Alejandro-KO/Mini-sumo-REM/IMG_20210524_221510.jpg

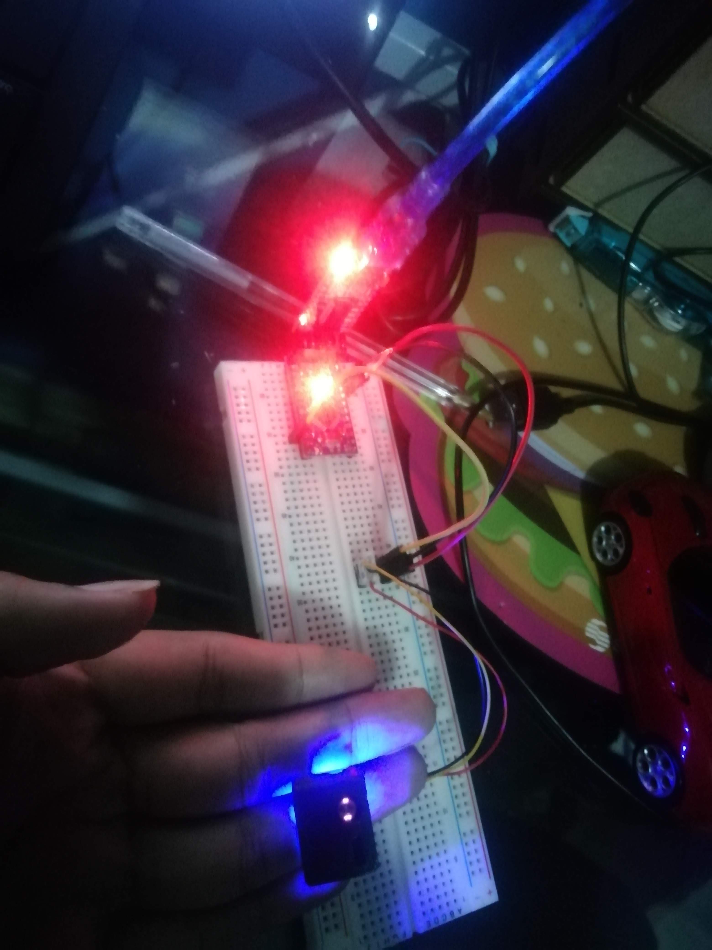
IMG_20210524_221510.jpg
