Alejandro-KO/Mini-sumo-REM/IMG_20210608_114437.jpg

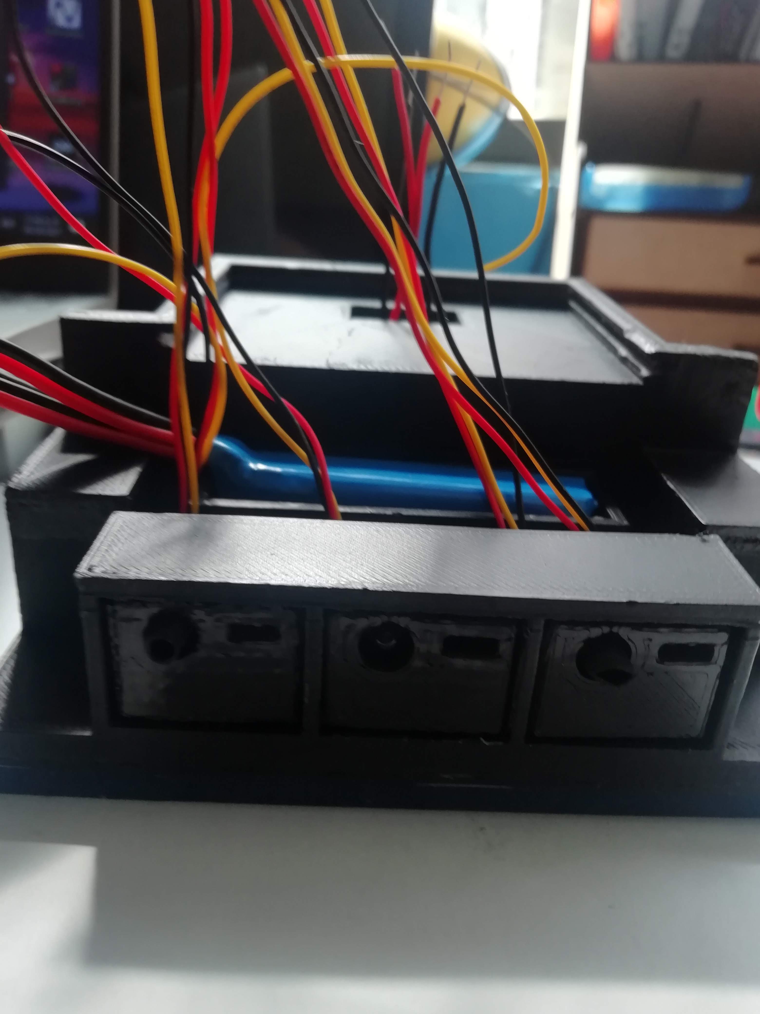
IMG_20210608_114437.jpg
