Alejandro-KO/Mini-sumo-REM/DOCUMENTACION/4to Avance de Proyecto.pdf

## “Avances de Proyecto”

## Titulo del proyecto: R.E.M Integrante(es): Israel Alejandro Murillo García Asesor(es): David de Jesús Ulises Hernández González

## Fecha de entrega

## Jun 2021

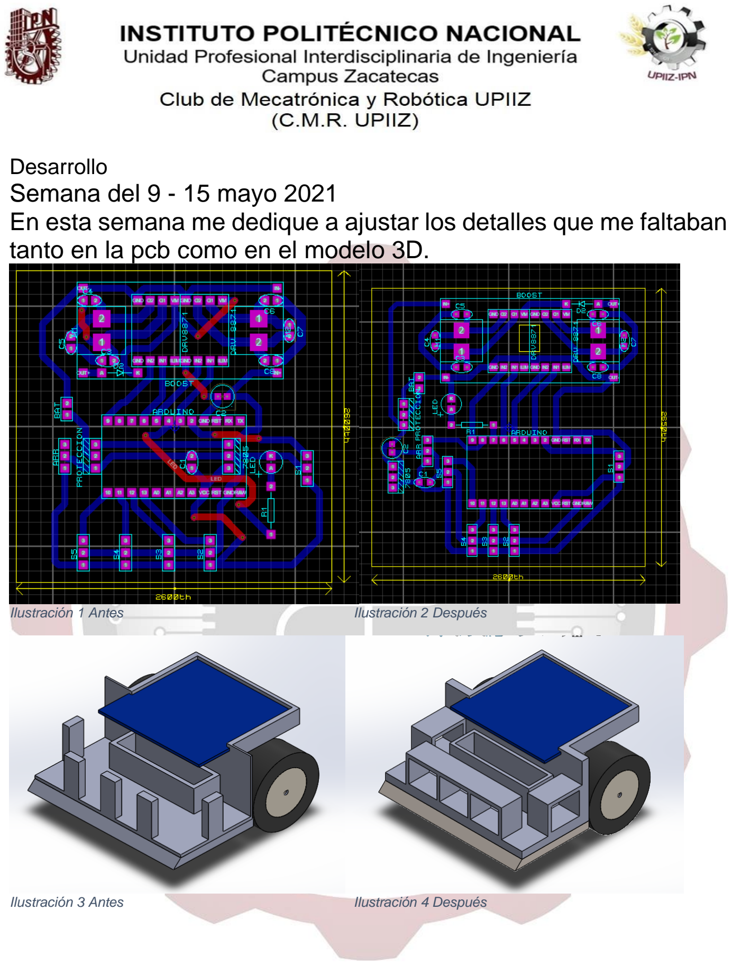
[picture p25: page 2]

Desarrollo
Semana del 9 - 15 mayo 2021
En esta semana me dedique a ajustar los detalles que me faltaban tanto en la pcb como en el modelo 3D.
Ilustración 1 Antes | Ilustración 2 Después
Ilustración 3 Antes | Ilustración 4 Después

Semana del 16 – 22 de mayo de 2021 Realice pruebas con los sensores.

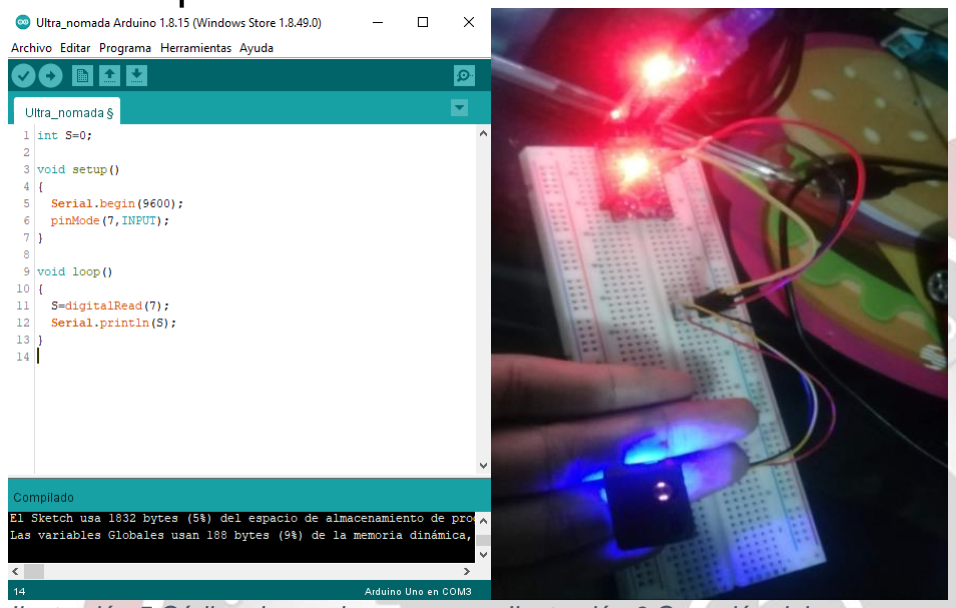
[picture p26: figure]

Ilustración 5 Código de pruebas | Ilustración 6 Conexión del sensor
No jalaron 2 de los sensores.

En estos días me eh atrasado un poco con el proyecto pero es debido a que últimamente eh tenido muchos trabajos de clase y no me dejan mucho tiempo para poder avanzar de mejor manera
