Alejandro-KO/Mini-sumo-REM/DOCUMENTACION/Avance de proyecto.pdf

# “Avances de Proyecto”

# Titulo del proyecto: R.E.M Integrante(es): Israel Alejandro Murillo García Asesor(es): David Hernández

# Fecha de entrega (ejem: marzo 2021):

Descripción de actividades realizadas en las 2 semanas de trabajo previas a la reunión de avances, asiendo énfasis en:

- Que días se realizaron.
- Quienes participaron.
- Que se realizo.
- Que falto (material, herramienta, diseño, cálculos, etc.).
- Que tipo de pruebas de realizaron (en caso de haber hecho).

El desarrollo de este formato es bastante libre, con la intención de que sea rápido de crear, deben ser al menos 2 cuartillas de información.
Nota: Agregar toda la evidencia posible (fotos, diagramas, simulaciones, diseños, etc.)
Nota 2: El listado anterior NO esta en orden, puede ser reorganizado cómo se crea conveniente.

Desarrollo
En estas semanas de trabajo el avance fue muy reducido, esto debido a la semana de exámenes.
Se realizo la investigación de los componentes que usare para la realización de mi robot mini sumo, así como el funcionamiento de algunos de ellos:
Sensores ultrasónicos

Estos sensores funcionan a base de emisión de ondas de sonido mandando y recibiendo ondas para así poder medir una distancia.


Puente h drv8871
Con estos circuitos integrados se va a controlar la velocidad de los motores


Tarjeta Arduino pro mini


En esta tarjeta se realizará todo el código del mini sumó

Elevador de voltaje Boost Xl6009 con este dispositivo se puede dar mayor potencia a los
moteres


Bateria de li-po de 350mAh

Esta es la batería que dará poder al mini sumo entre mas amperaje tenga mayor duración tendrá

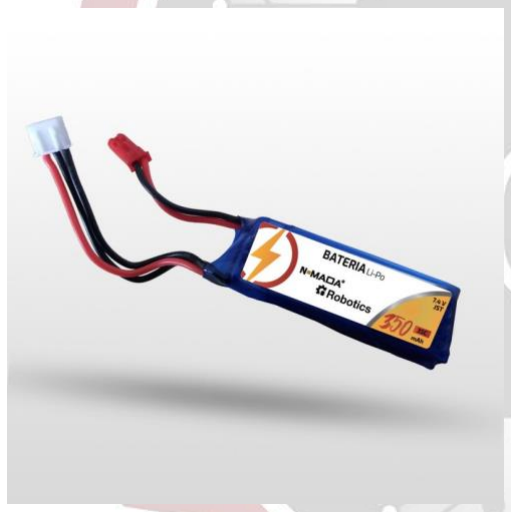
[picture p27: figure]
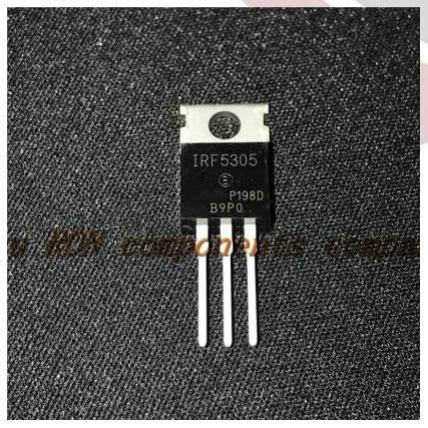
[picture p28: figure]

Mosfet irf5305
Este componente me ayudara a que no ocurra un corto al conectar de manera correcta la bateria
