Alejandro-KO/Mini-sumo-REM/DOCUMENTACION/Avances de Proyecto.docx

“Avances de Proyecto”

Titulo del proyecto:

R.E.M

Integrante(es):

Israel Alejandro Murillo García

Asesor(es):

David de Jesús Ulises Hernández González

Fecha de entrega

Jun 2021

Desarrollo

En estas dos semanas estuve trabajando en la etapa final de mi proyecto, teniendo así ya la placa, el modelo 3D impreso y la base donde van los motores

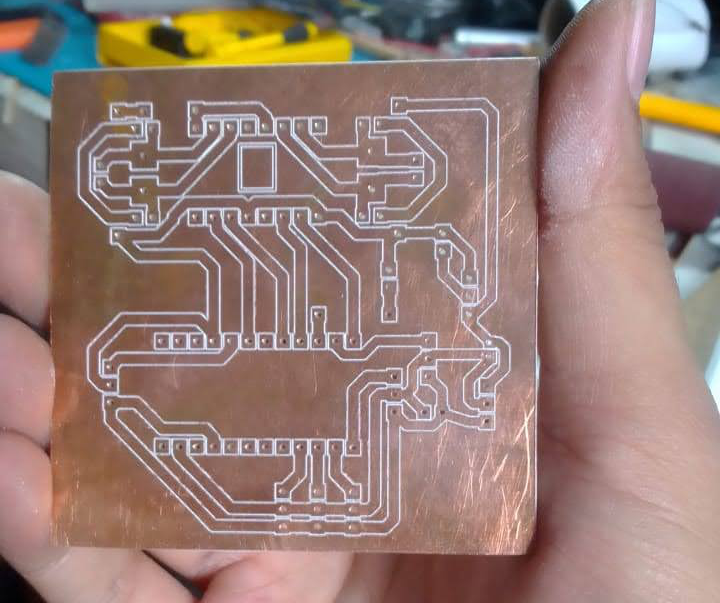
[picture p29: figure]
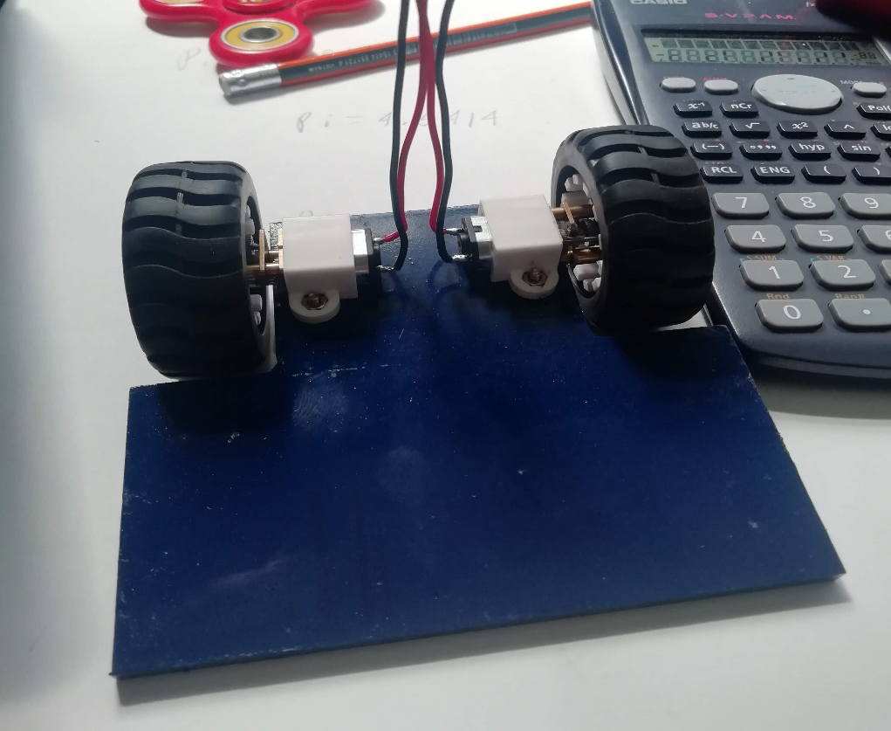
[picture p30: figure]
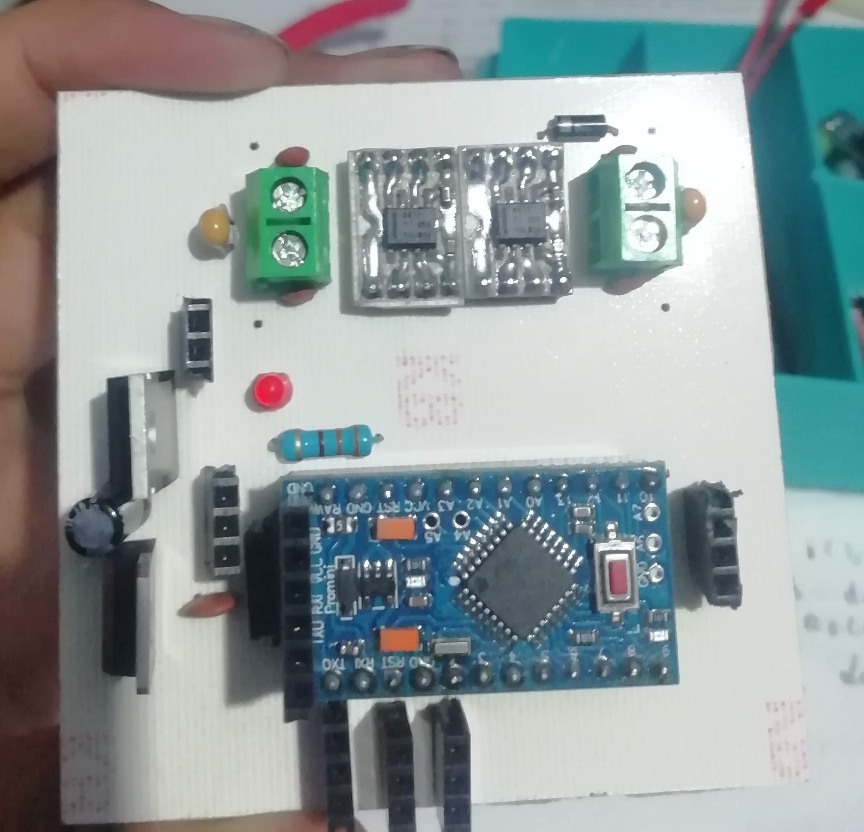
[picture p31: figure]
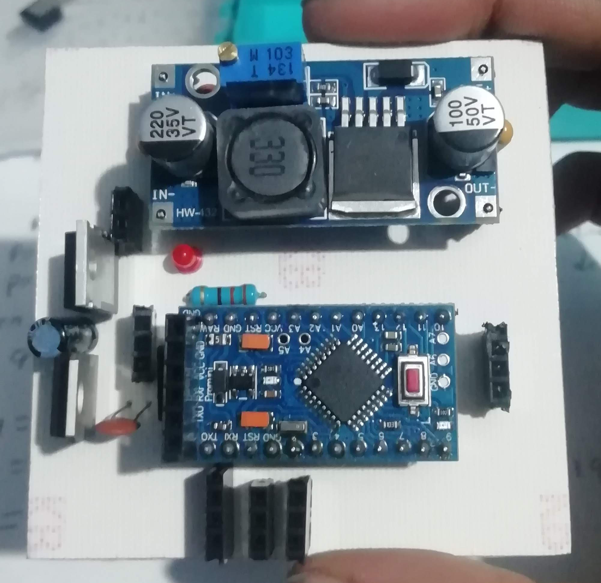
[picture p32: figure]
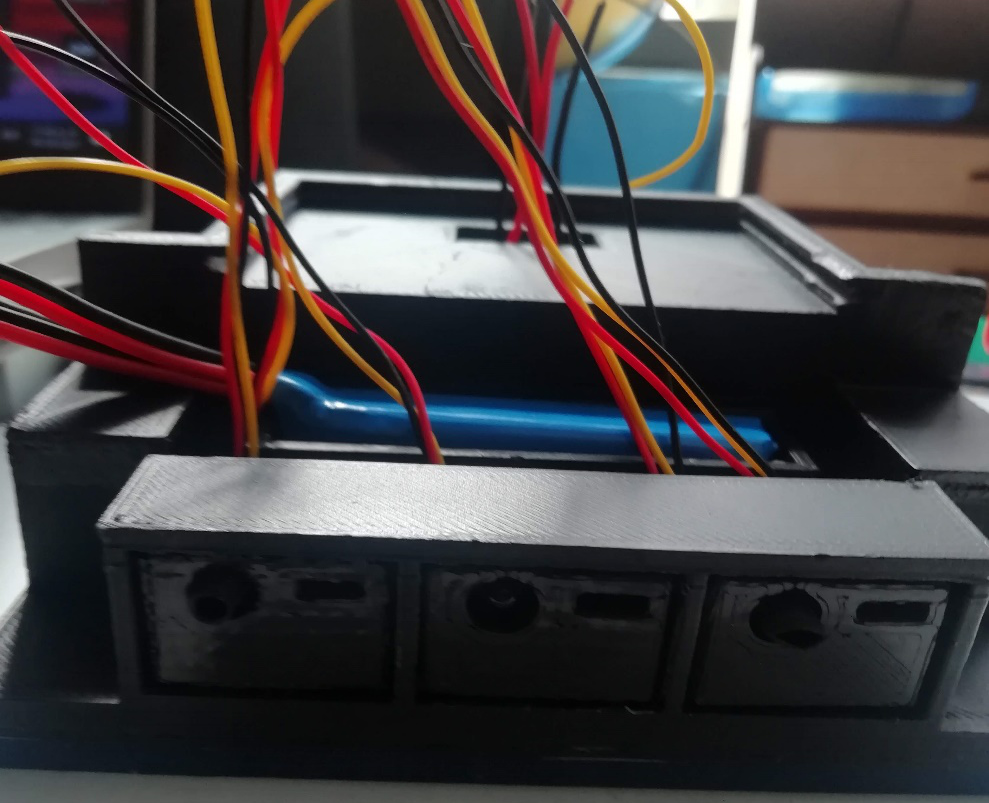
[picture p33: figure]
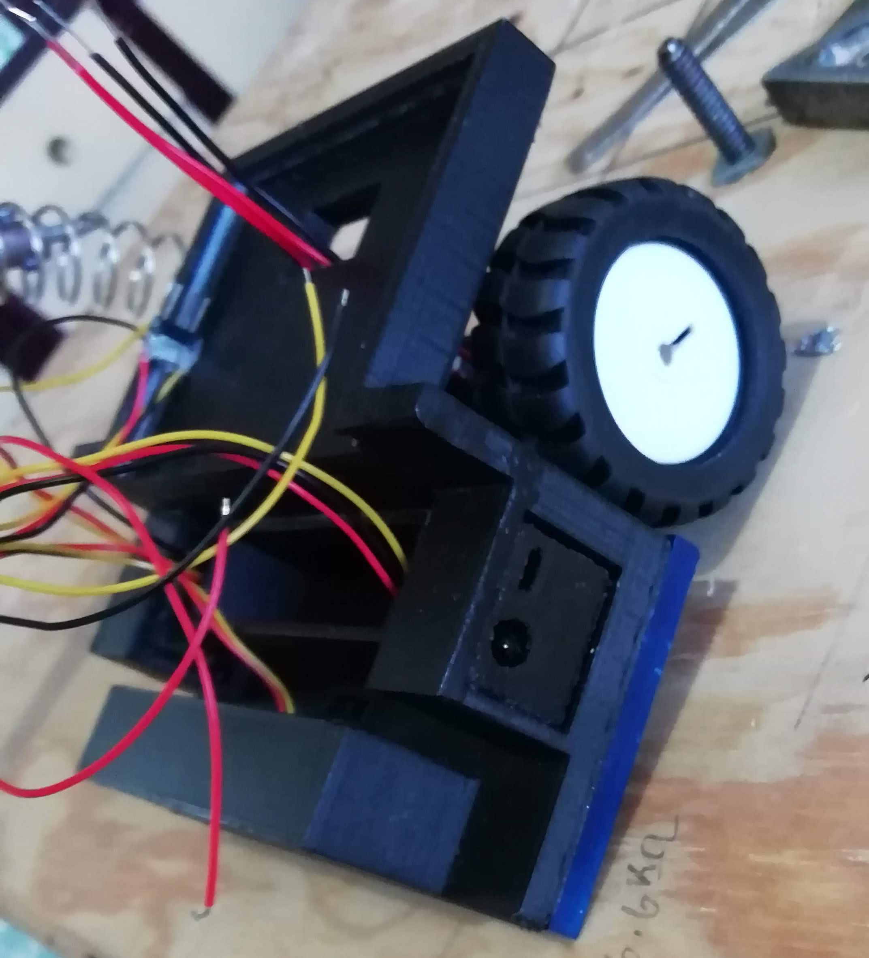
[picture p34: figure]
