Alejandro-KO/Mini-sumo-REM/DOCUMENTACION/5to Avance de Proyecto.pdf

# “Avances de Proyecto”

# Titulo del proyecto: R.E.M Integrante(es): Israel Alejandro Murillo García Asesor(es): David de Jesús Ulises Hernández González

# Fecha de entrega

# Jun 2021

Desarrollo
En estas dos semanas estuve trabajando en la etapa final de mi proyecto, teniendo así ya la placa, el modelo 3D impreso y la base donde van los motores

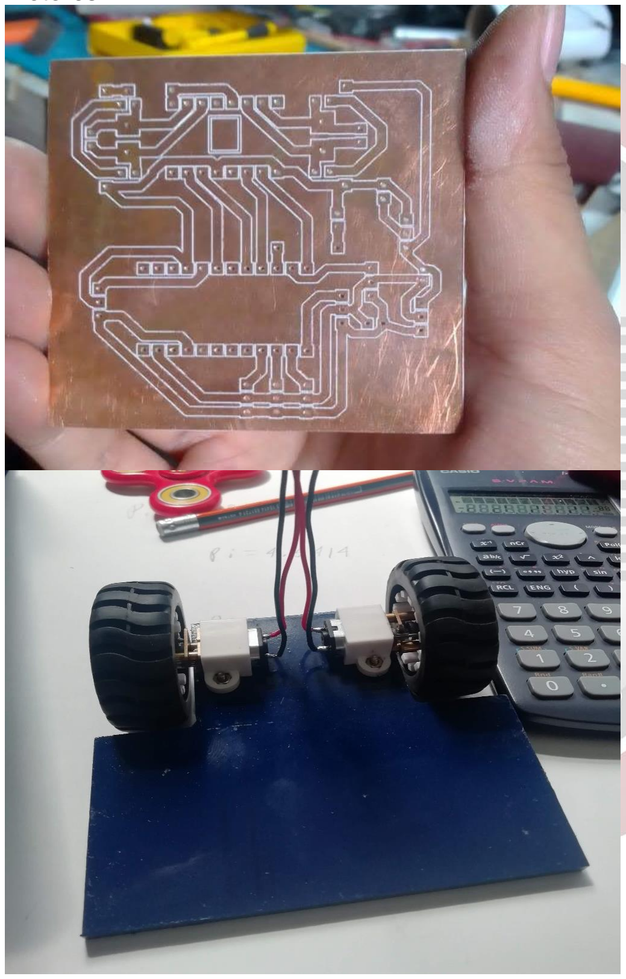
[picture p35: figure]

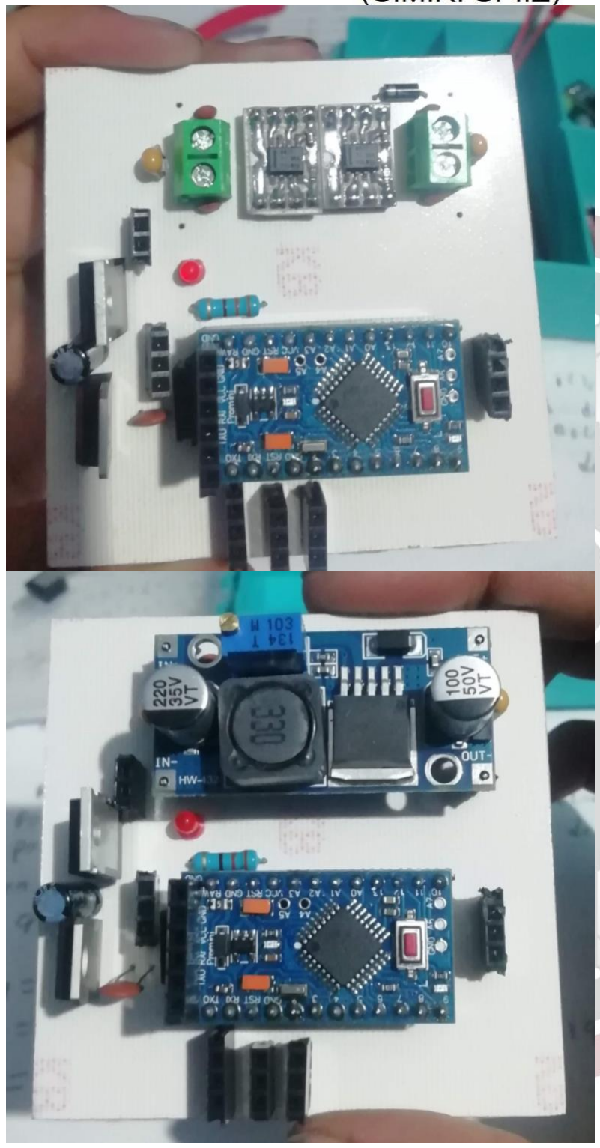
[picture p36: figure]

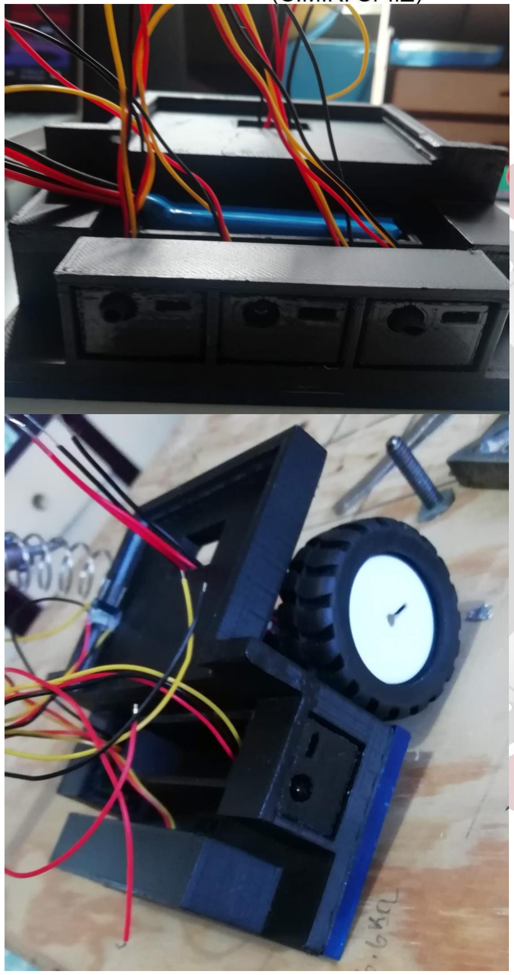
[picture p37: figure]
