Alejandro-KO/Mini-sumo-REM/IMG-20210607-WA0034.jpg

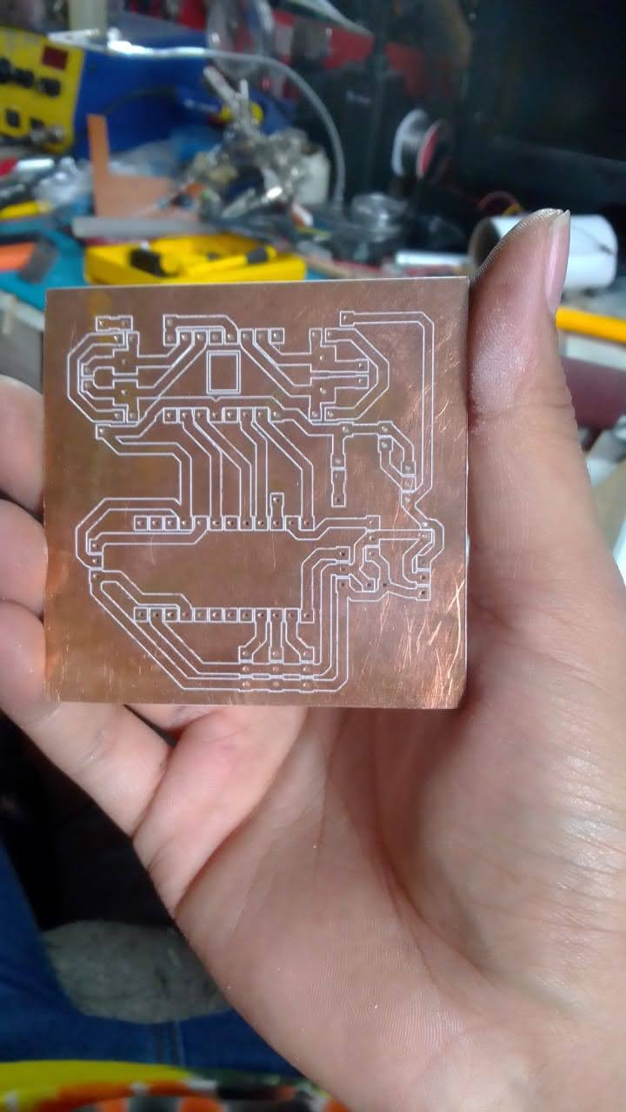
IMG-20210607-WA0034.jpg
