Alejandro-KO/Mini-sumo-REM/IMG_20210404_165855.jpg

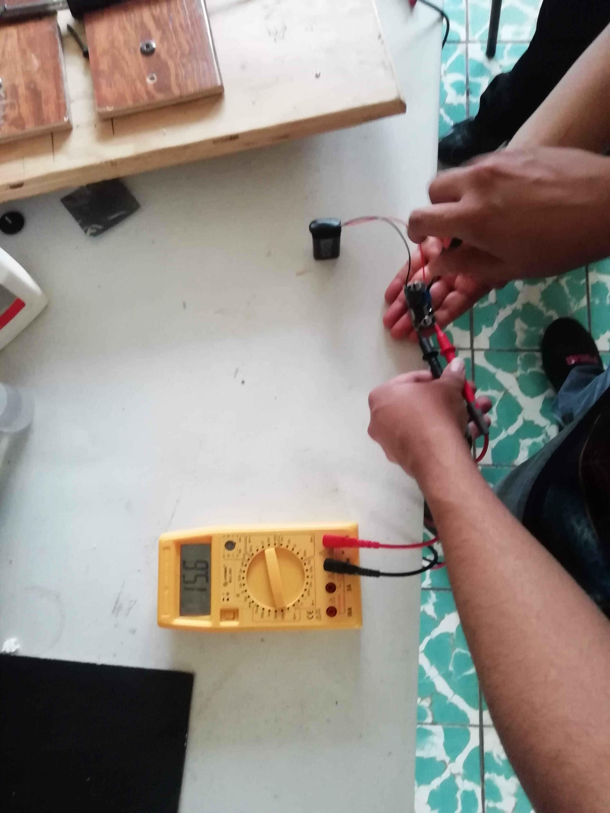
IMG_20210404_165855.jpg
