Alejandro-KO/Mini-sumo-REM/IMG_20210404_165900_1.jpg

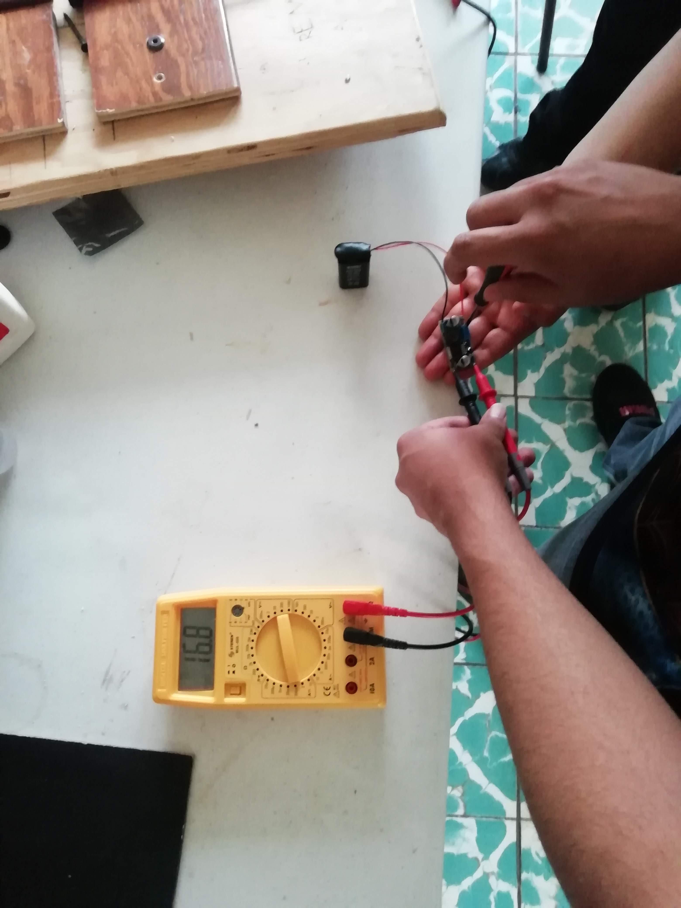
IMG_20210404_165900_1.jpg
