Alejandro-KO/Mini-sumo-REM/IMG_20210414_123741.jpg

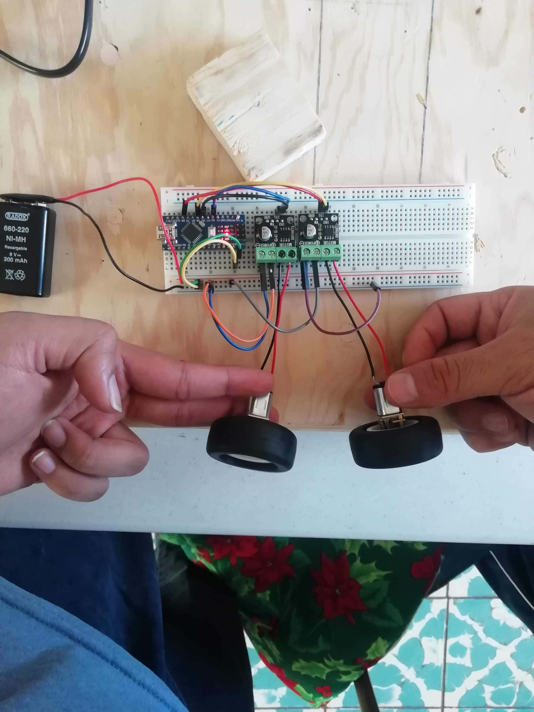
IMG_20210414_123741.jpg
