Alejandro-KO/Mini-sumo-REM/IMG_20210606_190317.jpg

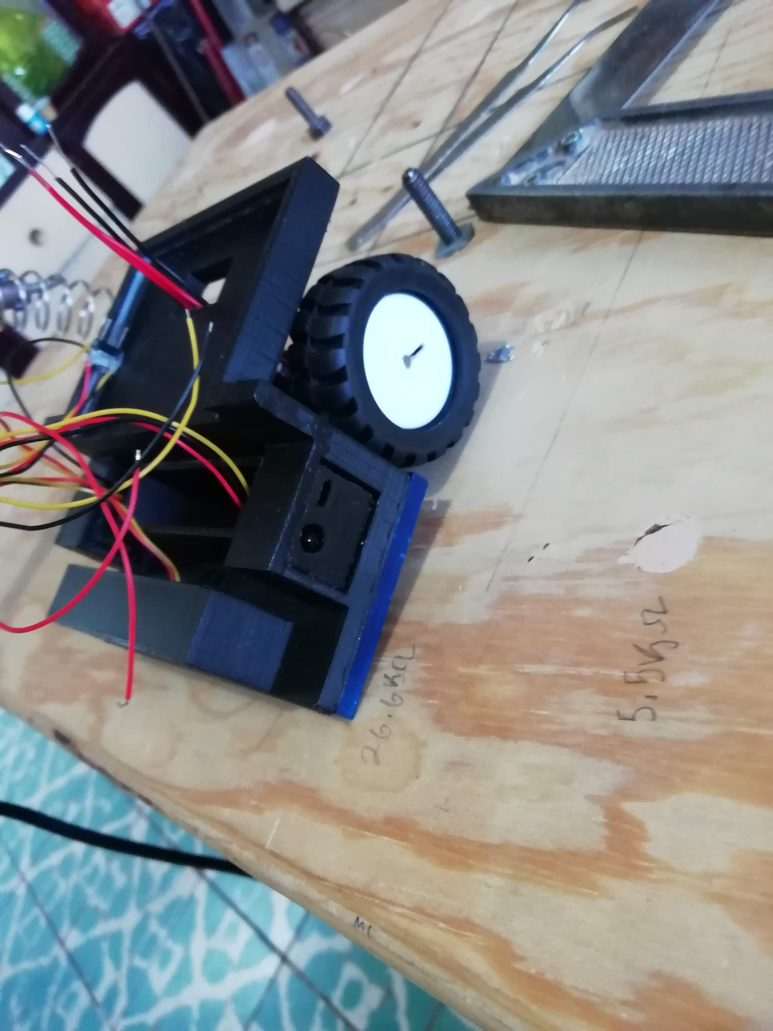
IMG_20210606_190317.jpg
