Alejandro-KO/Mini-sumo-REM/IMG_20210608_004412.jpg

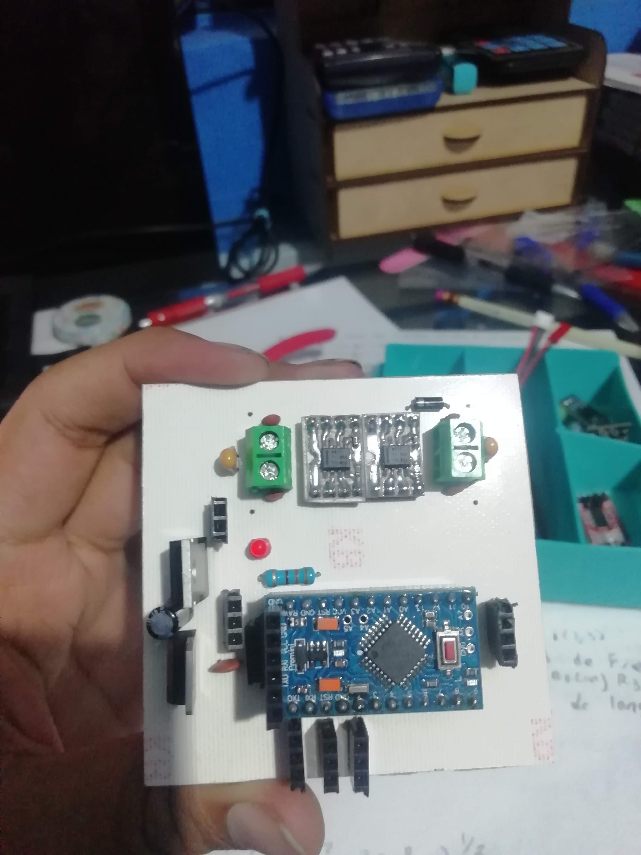
IMG_20210608_004412.jpg
