Alejandro-KO/Mini-sumo-REM/IMG_20210608_004551.jpg

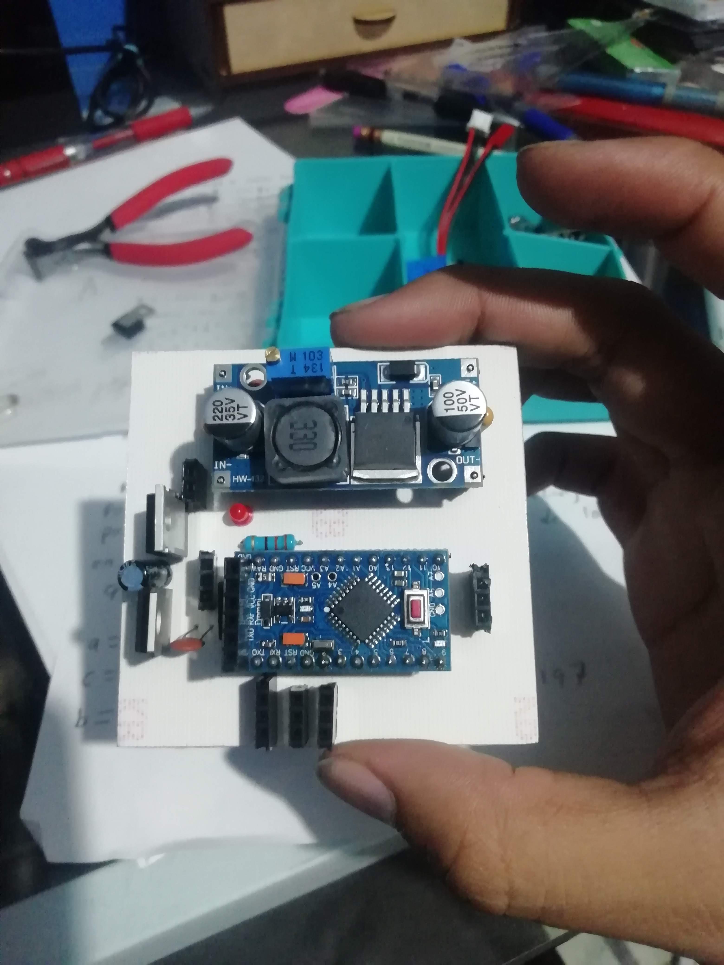
IMG_20210608_004551.jpg
