Alejandro-KO/Mini-sumo-REM/IMG_20210608_114411.jpg

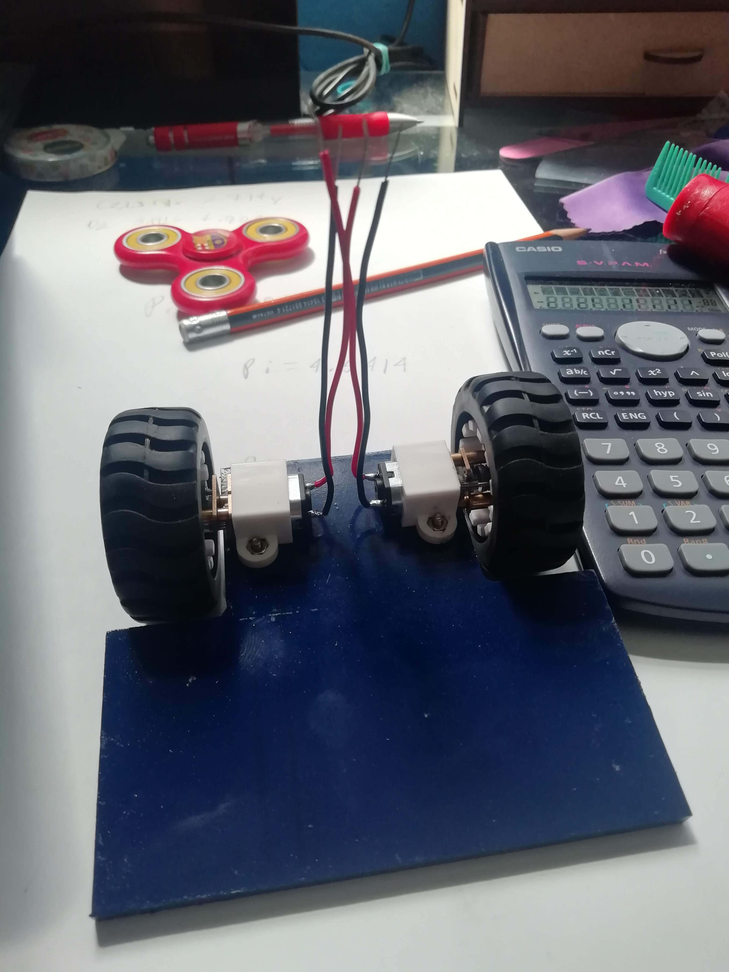
IMG_20210608_114411.jpg
