Alejandro-KO/Mini-sumo-REM/SOLIDWORKS/REM.SLDASM

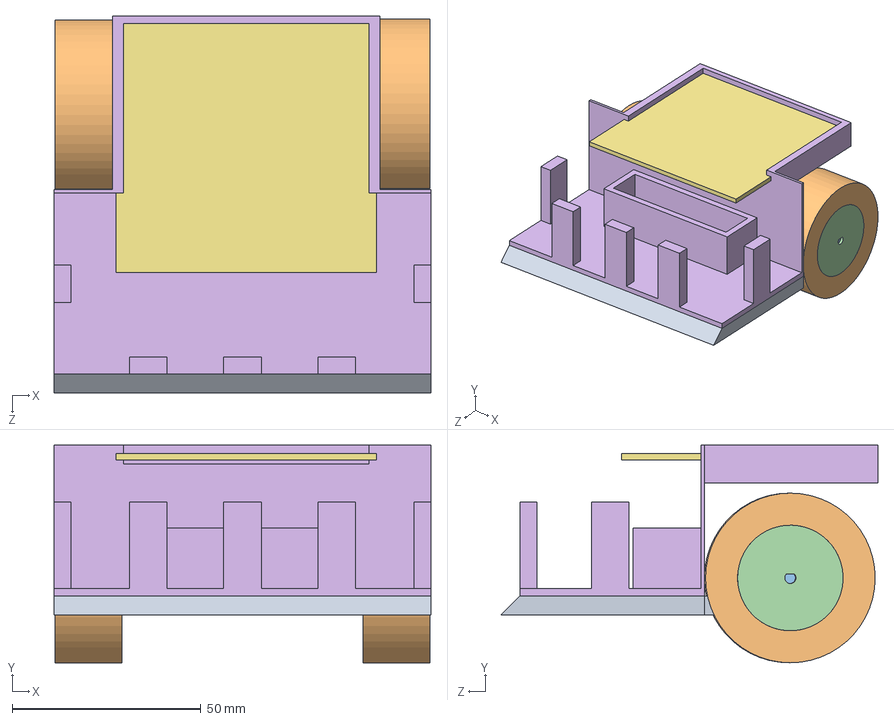
[picture p46: CAD file, 2024-09-05]
SOLIDWORKS/REM.SLDASM
100.0 x 57.7 x 100.0 mm
Base de REM 2
Llantas de REM x 2
motores de REM x 2
Rines de REM x 2
Sujetador de motor de REM x 2
Cuerpo de REM
PCB de REM
