Alejandro-KO/Mini-sumo-REM/SOLIDWORKS/Ruedas de REM.SLDASM

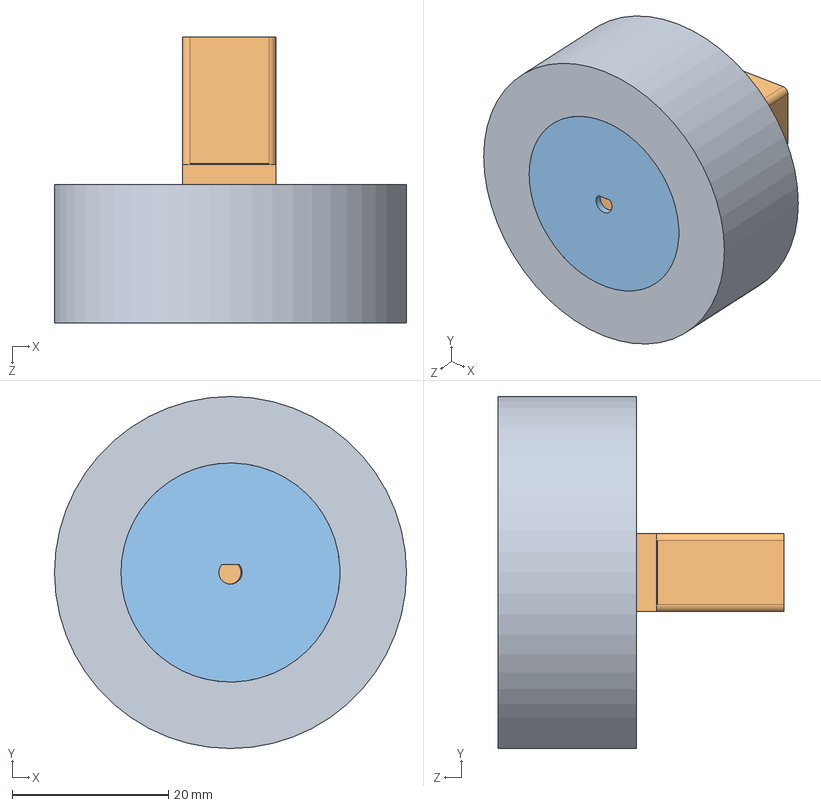
[picture p47: CAD file, 2024-09-05]
SOLIDWORKS/Ruedas de REM.SLDASM
45.0 x 45.0 x 36.6 mm
Llantas de REM
motores de REM
Rines de REM
