Alejandro-KO/Mini-sumo-REM/SOLIDWORKS/Rem2.0.SLDASM

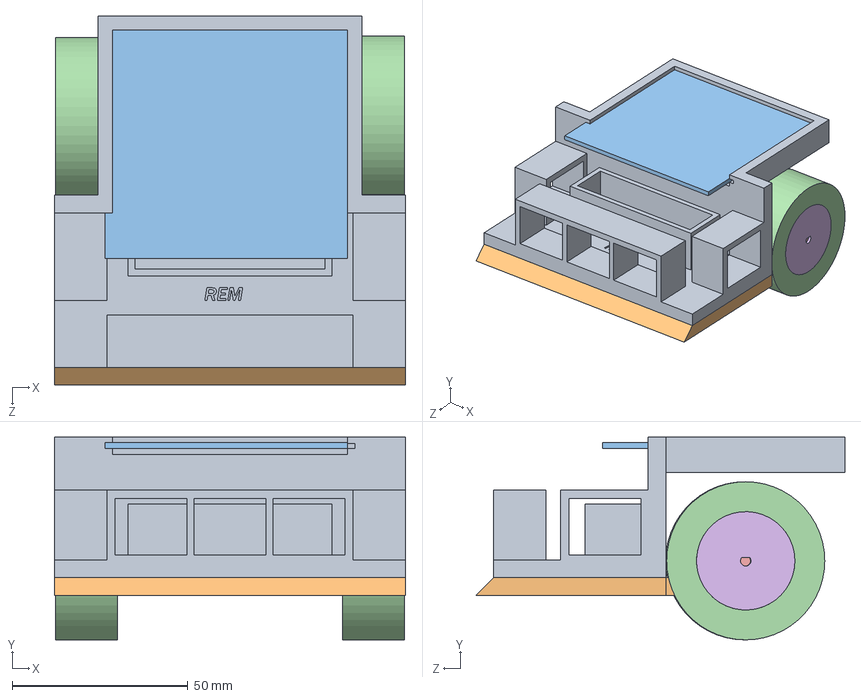
[picture p48: CAD file, 2024-09-05]
SOLIDWORKS/Rem2.0.SLDASM
100.0 x 57.7 x 105.0 mm
Base de REM
Base de REM 2
PCB de REM
Llantas de REM x 2
motores de REM x 2
Rines de REM x 2
Sujetador de motor de REM x 2
