Alejandro-KO/Mini-sumo-REM/Base de REM.SLDPRT

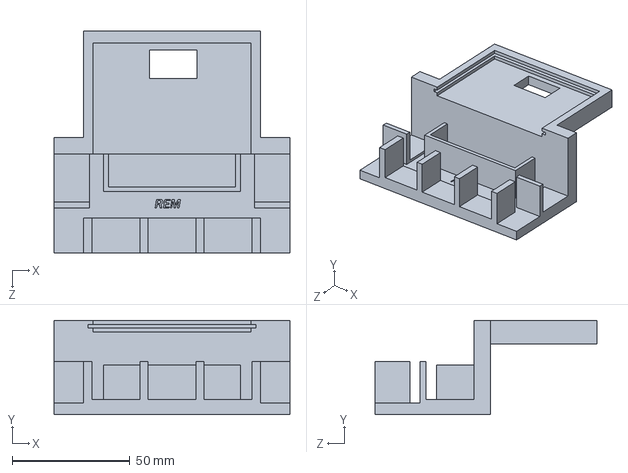
[picture p49: CAD file, 2024-09-05]
Base de REM.SLDPRT
100.0 x 40.0 x 94.0 mm
