Alejandro-KO/Mini-sumo-REM/REM 3.0/Base.SLDPRT

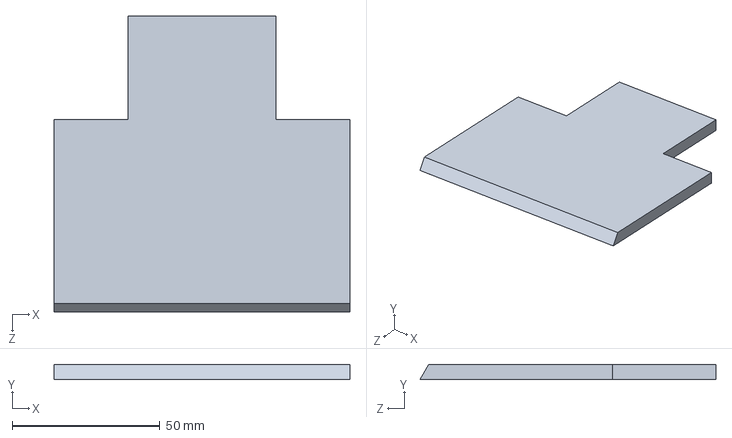
[picture p50: CAD file, 2024-09-05]
REM 3.0/Base.SLDPRT
100.0 x 5.00 x 100.0 mm
