Alejandro-KO/Mini-sumo-REM/REM 5.0/Chasis.SLDPRT

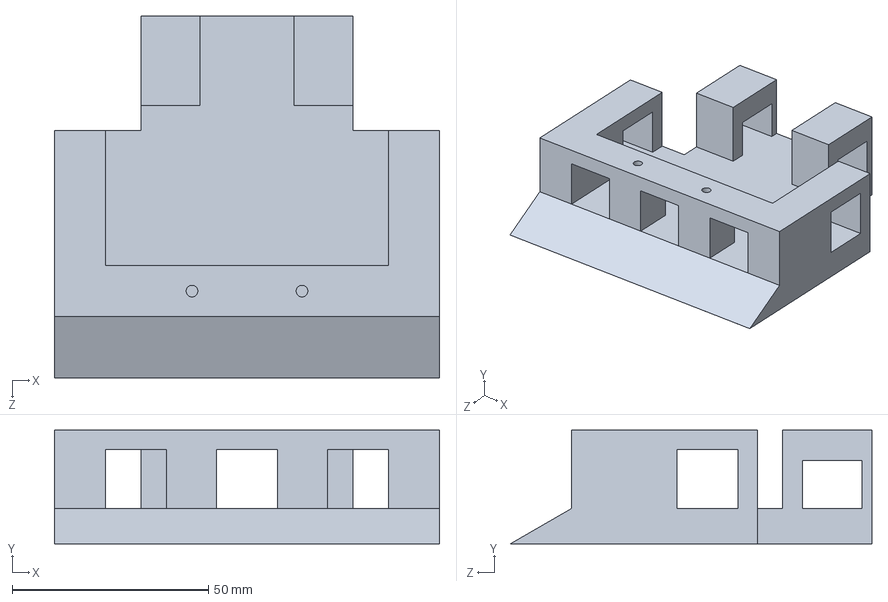
[picture p51: CAD file, 2024-09-05]
REM 5.0/Chasis.SLDPRT
98.0 x 29.0 x 92.1 mm
