Alejandro-KO/Mini-sumo-REM/SOLIDWORKS/PCB de REM.SLDPRT

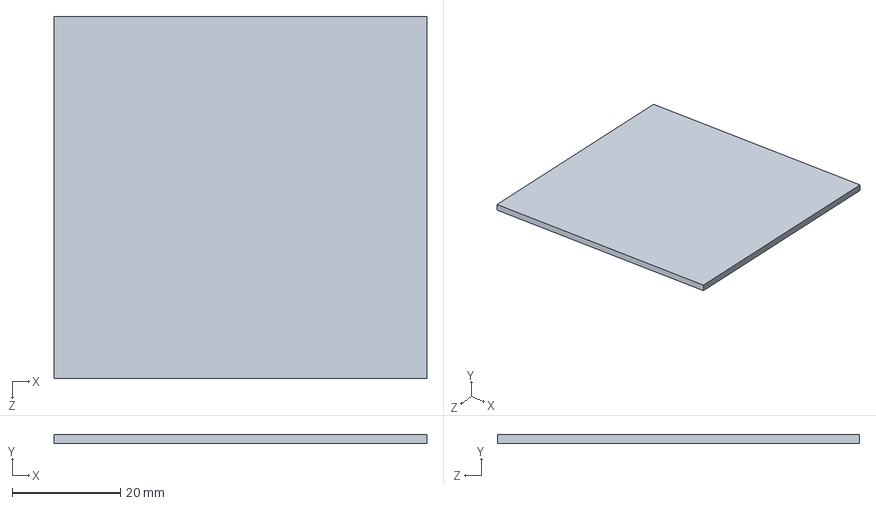
[picture p52: CAD file, 2024-09-05]
SOLIDWORKS/PCB de REM.SLDPRT
69.0 x 1.70 x 67.0 mm
