Alejandro-KO/Mini-sumo-REM/REM 3.0/Sensor.SLDPRT

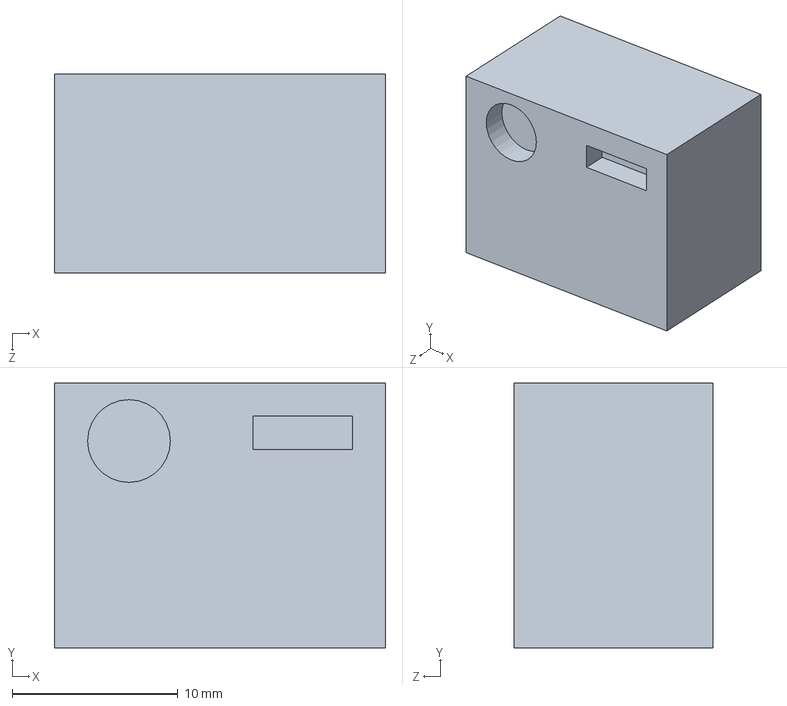
[picture p53: CAD file, 2024-09-05]
REM 3.0/Sensor.SLDPRT
20.0 x 16.0 x 12.0 mm
