Alejandro-KO/Mini-sumo-REM/REM 5.0/Sensor.SLDPRT

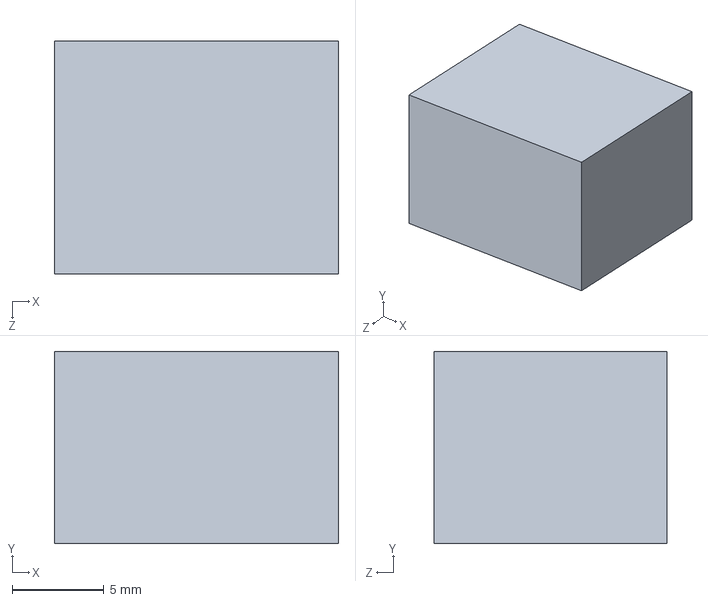
[picture p54: CAD file, 2024-09-05]
REM 5.0/Sensor.SLDPRT
15.5 x 10.5 x 12.7 mm
