Alejandro-KO/Mini-sumo-REM/SOLIDWORKS/Base de REM 2.SLDPRT

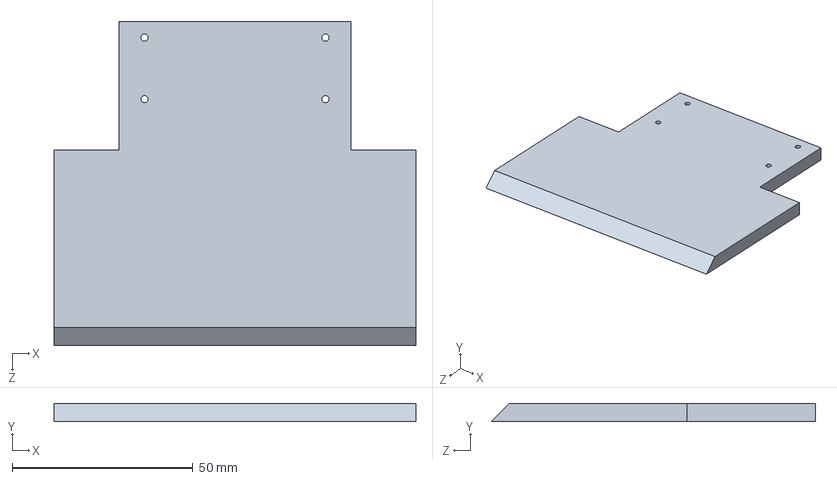
[picture p55: CAD file, 2024-09-05]
SOLIDWORKS/Base de REM 2.SLDPRT
100.0 x 5.00 x 89.6 mm
