Alejandro-KO/Mini-sumo-REM/REM 3.0/Cuerpo.SLDPRT

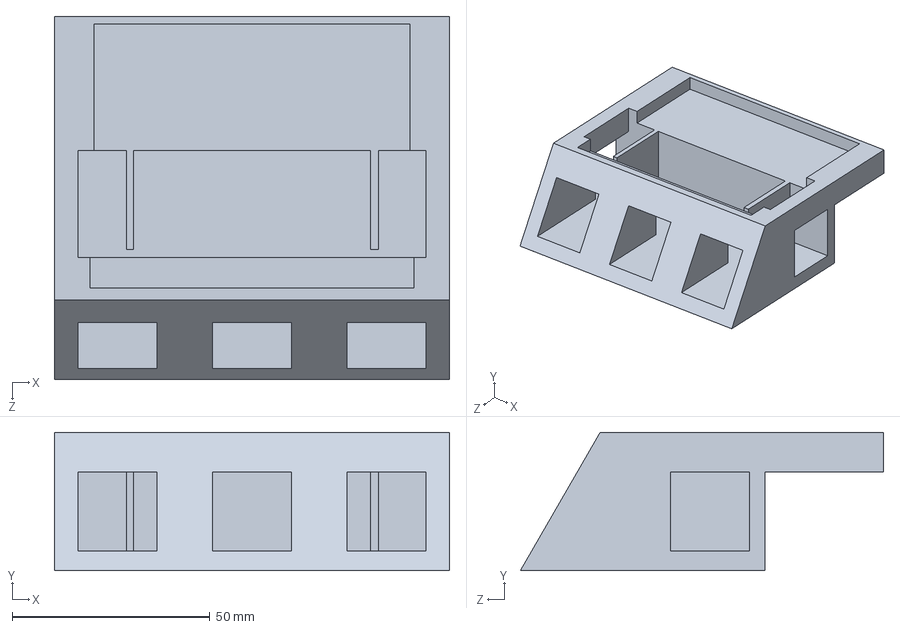
[picture p56: CAD file, 2024-09-05]
REM 3.0/Cuerpo.SLDPRT
100.0 x 35.0 x 92.0 mm
