Alejandro-KO/Mini-sumo-REM/SOLIDWORKS/Llantas de REM.SLDPRT

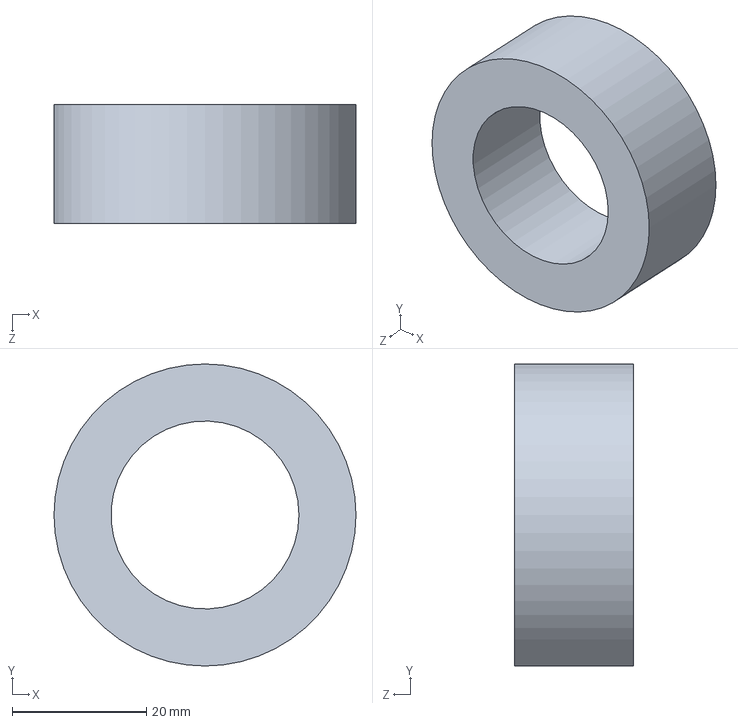
[picture p57: CAD file, 2024-09-05]
SOLIDWORKS/Llantas de REM.SLDPRT
45.0 x 45.0 x 17.7 mm
