Alejandro-KO/Mini-sumo-REM/REM 3.0/Soporte de motor.SLDPRT

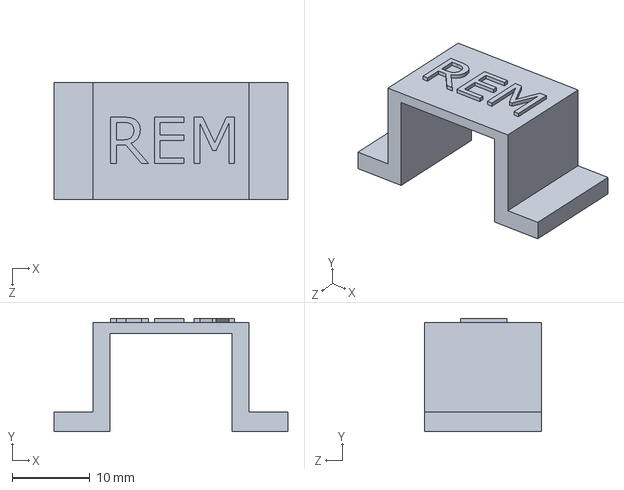
[picture p58: CAD file, 2024-09-05]
REM 3.0/Soporte de motor.SLDPRT
30.0 x 14.5 x 15.0 mm
