Alejandro-KO/Mini-sumo-REM/SOLIDWORKS/motores de REM.SLDPRT

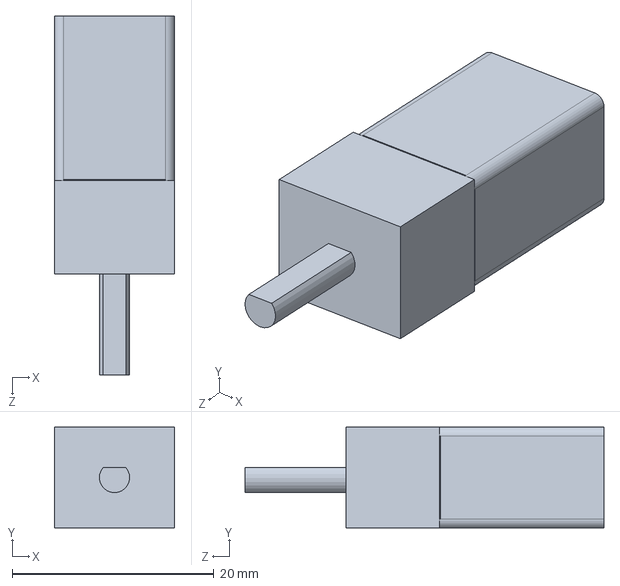
[picture p59: CAD file, 2024-09-05]
SOLIDWORKS/motores de REM.SLDPRT
11.9 x 10.0 x 35.6 mm
