Alejandro-KO/Mini-sumo-REM/REM 3.0/Llanta.SLDPRT

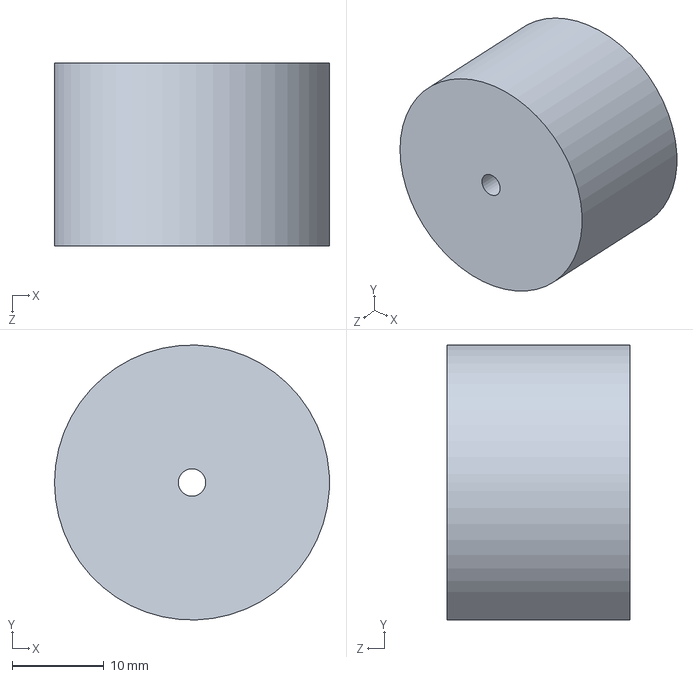
[picture p60: CAD file, 2024-09-05]
REM 3.0/Llanta.SLDPRT
30.0 x 30.0 x 20.0 mm
