Alejandro-KO/Mini-sumo-REM/SOLIDWORKS/Sujetador de motor de REM.SLDPRT

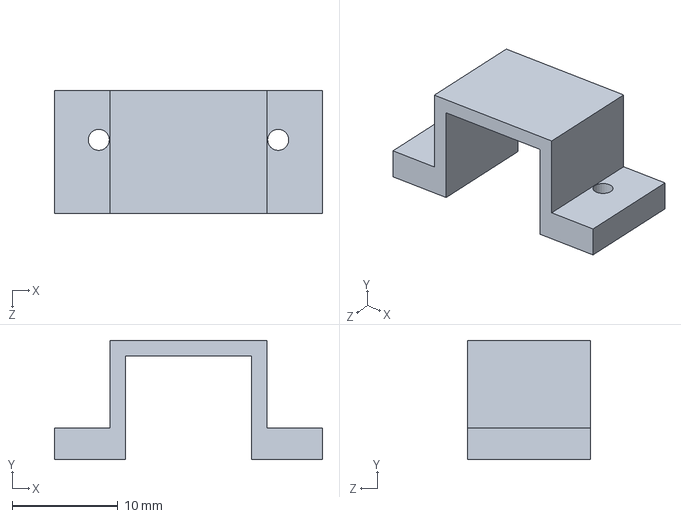
[picture p61: CAD file, 2024-09-05]
SOLIDWORKS/Sujetador de motor de REM.SLDPRT
25.4 x 11.3 x 11.7 mm
