Alejandro-KO/Mini-sumo-REM/REM 3.0/Motor.SLDPRT

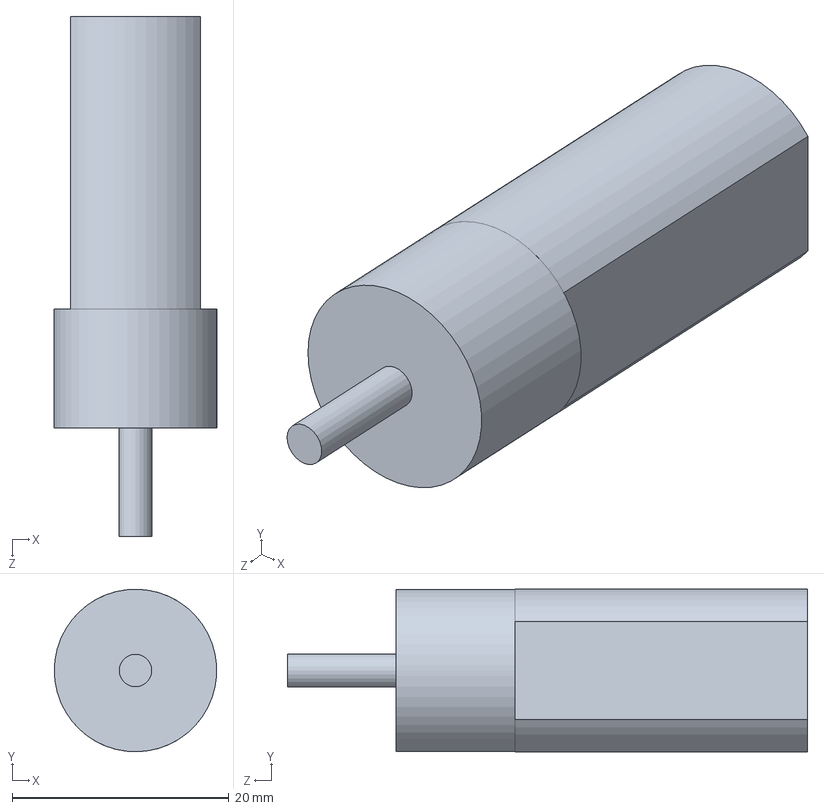
[picture p62: CAD file, 2024-09-05]
REM 3.0/Motor.SLDPRT
15.0 x 15.0 x 48.0 mm
