Alejandro-KO/Mini-sumo-REM/SOLIDWORKS/Rines de REM.SLDPRT

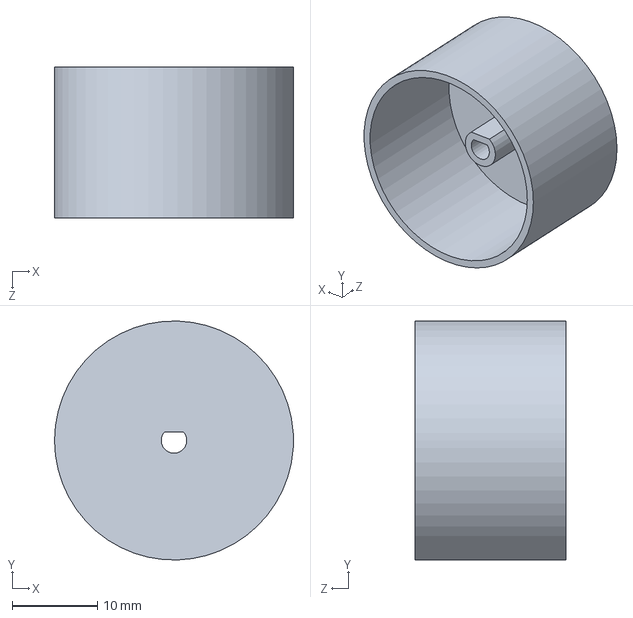
[picture p63: CAD file, 2024-09-05]
SOLIDWORKS/Rines de REM.SLDPRT
28.0 x 28.0 x 17.7 mm
