Alejandro-KO/Mini-sumo-REM/SOLIDWORKS/Cuerpo de REM.SLDPRT

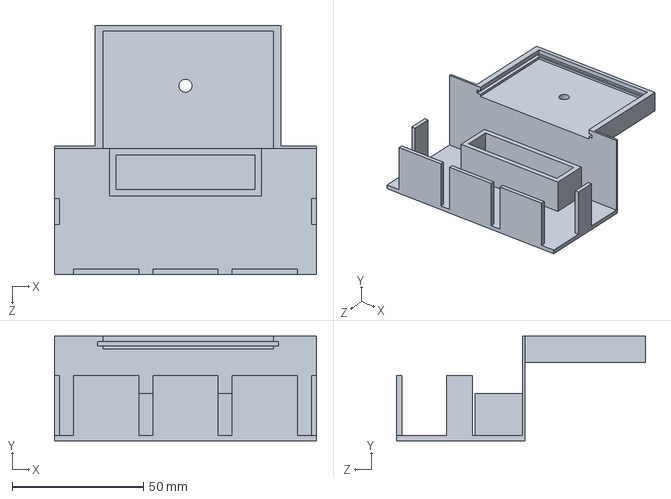
[picture p64: CAD file, 2024-09-05]
SOLIDWORKS/Cuerpo de REM.SLDPRT
100.0 x 40.0 x 95.0 mm
