Alejandro-KO/Mini-sumo-REM/(list of files, cad)

Other CAD files:
REM 5.0/Chasis2.SLDPRT
Base de REM 2.SLDDRW
Base de REM.STL
REM 3.0/Cuerpo.STL
REM 3.0/Soporte de motor.STL
REM 5.0/Chasis.STL
REM 5.0/Chasis2.STL
SOLIDWORKS/Base de REM.SLDPRT
SOLIDWORKS/Base de REM.STL
