Alejandro-KO/Mini-sumo-REM/Base de REM 2.PDF

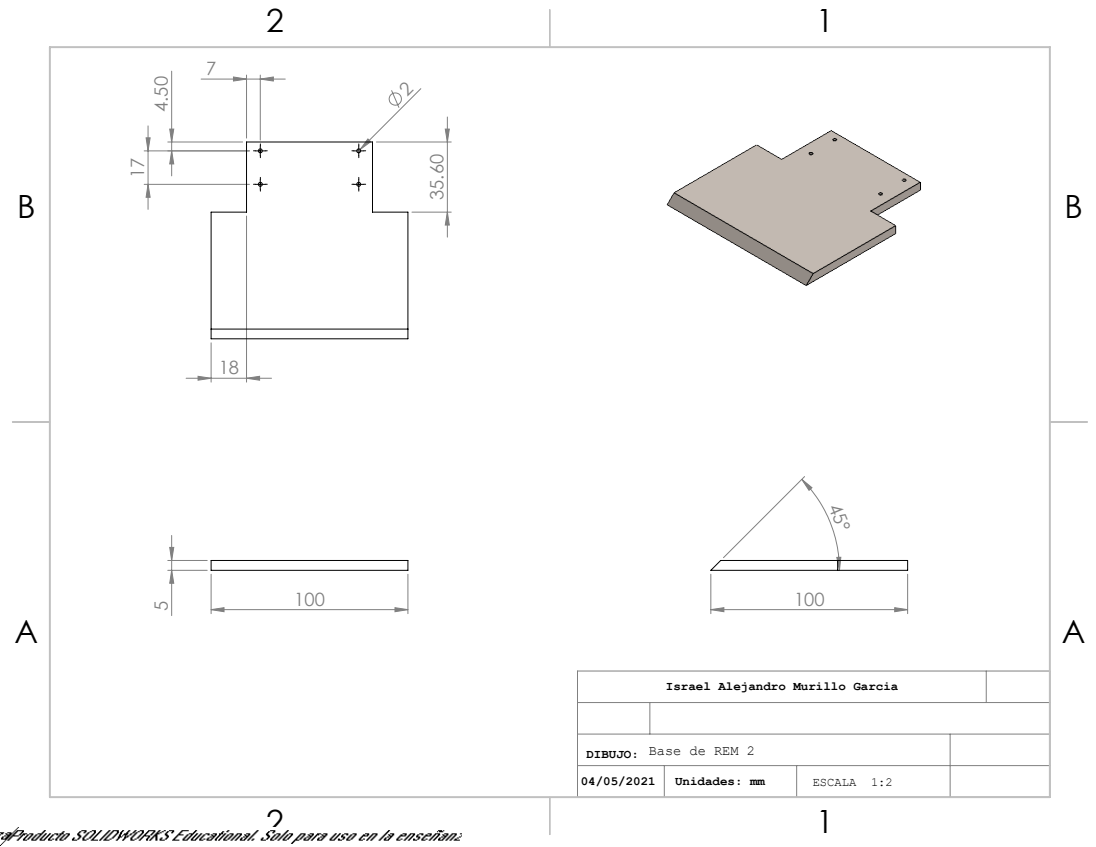
[picture p65: page 1]

Israel Alejandro Murillo Garcia

Base de REM 2 DIBUJO:
04/05/2021 | Unidades: mm | ESCALA 1:2
