Alejandro-KO/Mini-sumo-REM/(list of files, drawings)

Other design files:
PROTEUS/MINI SUMO REM.pdsprj
PROTEUS/Project Backups/REM [Proteus 8.4].pdsprj
PROTEUS/REM.pdsprj
REM 3.0/PROTEUS/Project Backups/REM_3.0 [20230414, 17-20-38].pdsprj
REM 3.0/PROTEUS/Project Backups/REM_3.0 [20230415, 00-59-15].pdsprj
REM 3.0/PROTEUS/Project Backups/REM_3.0 [20230416, 00-14-56].pdsprj
REM 3.0/PROTEUS/Project Backups/REM_3.0 [20230417, 01-28-36].pdsprj
REM 3.0/PROTEUS/Project Backups/REM_3.0 [20230417, 11-24-19].pdsprj
REM 3.0/PROTEUS/Project Backups/REM_3.0 [20230418, 09-19-01].pdsprj
REM 3.0/PROTEUS/REM_3.0.pdsprj
REM 4.0/Proteus/Project Backups/Rem4.0 [20230912, 00-07-53].pdsprj
REM 4.0/Proteus/Project Backups/Rem4.0 [20230914, 08-34-21].pdsprj
REM 4.0/Proteus/Project Backups/Rem4.0 [20230914, 14-29-11].pdsprj
REM 4.0/Proteus/Project Backups/Rem4.0 [20230930, 20-28-31].pdsprj
REM 4.0/Proteus/Rem4.0.pdsprj
REM 5.0/Project Backups/REM5 [20231203, 13-03-38].pdsprj
REM 5.0/Project Backups/REM5 [20231204, 08-22-34].pdsprj
REM 5.0/Project Backups/REM5 [20231204, 08-23-36].pdsprj
REM 5.0/REM5.pdsprj
